dhkimxx/smart-lamp/client/assets/images/child.jpg

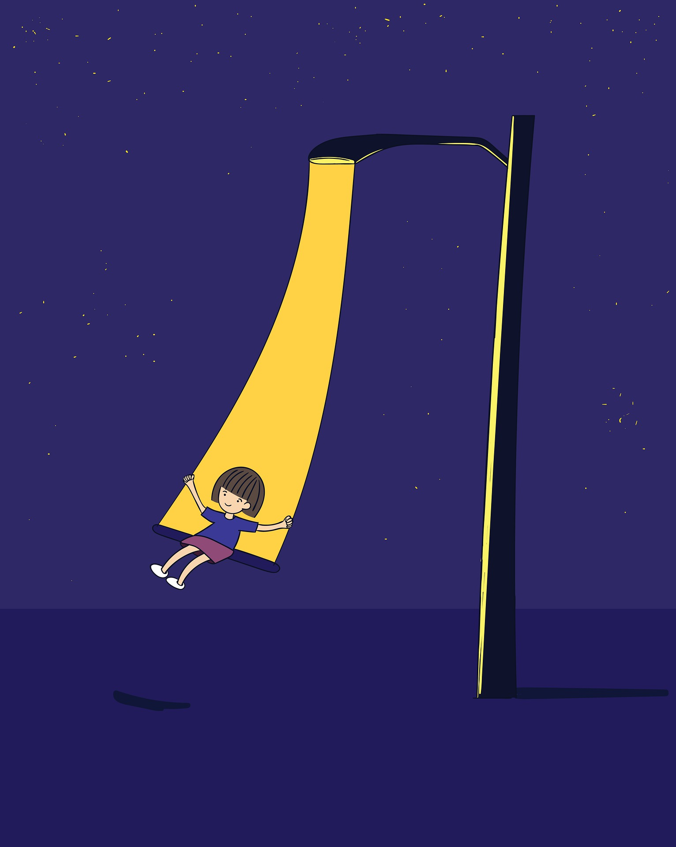
client/assets/images/child.jpg
