dhkimxx/smart-lamp/img/breadboard.jpg

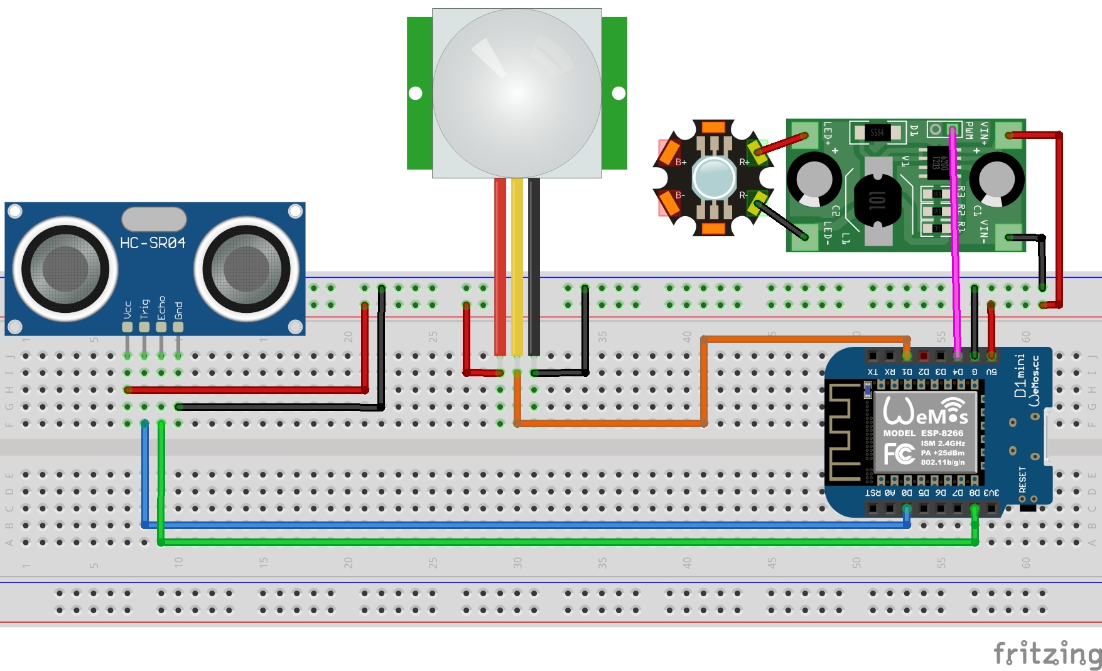
img/breadboard.jpg
