dhkimxx/smart-lamp/(commit log)

2023-04-06 on/off button
2023-05-20 add button
2023-05-23 led pwm driver
2023-06-26 feat: 로그인, 로그아웃 키보드로 인한 화면 오버플로우 해결
2023-09-16 add pir sensor function
2023-09-16 spring server
